kingoflolz/linear-actuator-hardware/readme.md

# Linear Actuator Hardware

A fully integrated PCB linear actuator, with the motor driver, encoder and motor all on a single PCB. All designs are
open source:

- [Firmware and host software](https://github.com/kingoflolz/linear-actuator-firmware)
- [Blog post with commentary](https://benwang.dev/2022/08/09/PCB-Linear-Actuator.html)

Files in this repository are licensed under the Apache-2.0 license
