kingoflolz/linear-actuator-hardware/mechanical/readme.md

# Mechanical components

| File | Material | Thickness  |
|---|---|---|
| Mount.stl | PLA | N/A |
| Stator plate 1.dxf | Mild steel | 3mm/0.119" |
| Stator plate 3.dxf | Mild steel | 3mm/0.119" |
| Stator spacer.dxf  | 5052 | 6.4mm/.25" |

The metal plates can be ordered at SendCutSend [here](https://cart.sendcutsend.com/1mcvzdwj3xs7)
