kingoflolz/linear-actuator-hardware/encoder_pcb/README.md

# Gerber generator for encoder PCB

What is GLIF?
========================
GLIF is a Gerber writer written in python. It takes graphical primitives such as lines, arcs, circles, polygons, and ASCII text and writes out valid RS-274X "Gerber" files. These files are typically used to manufacture PCBs.
