kingoflolz/linear-actuator-hardware/simulator/readme.md

# Magnetics Simulator

A python interface for [FEMM](https://www.femm.info/wiki/HomePage) which is used to implement a simulation for the linear actuator.
