kingoflolz/linear-actuator-hardware/simulator/idtestn0.bmp

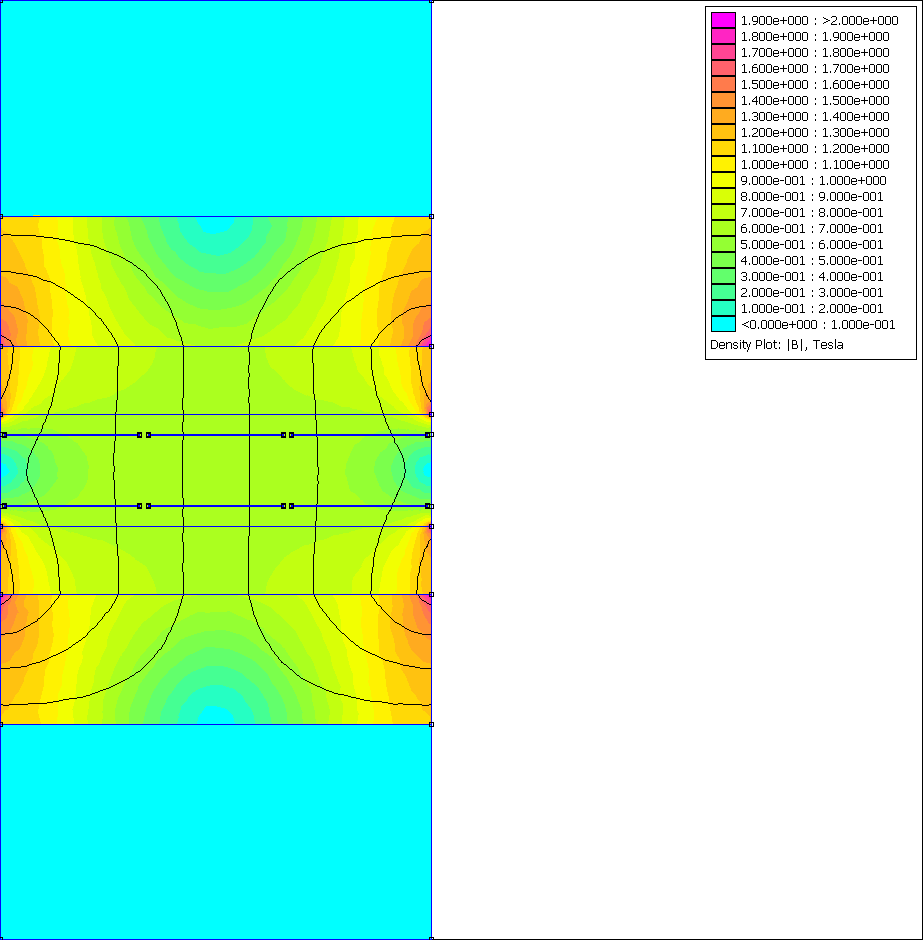
simulator/idtestn0.bmp
