kingoflolz/linear-actuator-hardware/mechanical/Part Studio 1 - Stator spacer.dxf

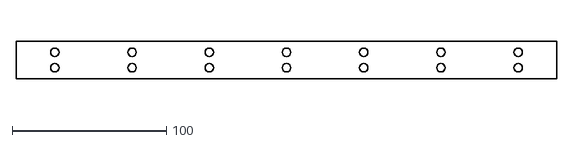
[picture p2: CAD file, 2022-08-09]
mechanical/Part Studio 1 - Stator spacer.dxf
350.0 x 24.0
