kingoflolz/linear-actuator-hardware/mechanical/Part Studio 1 - Stator plate 1.dxf

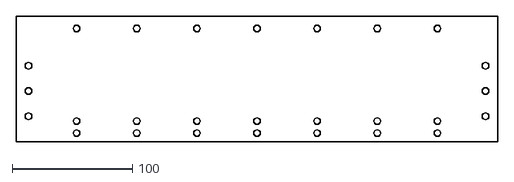
[picture p3: CAD file, 2022-08-09]
mechanical/Part Studio 1 - Stator plate 1.dxf
400.0 x 104.0
