kingoflolz/linear-actuator-hardware/mechanical/Part Studio 1 - Mount.stl

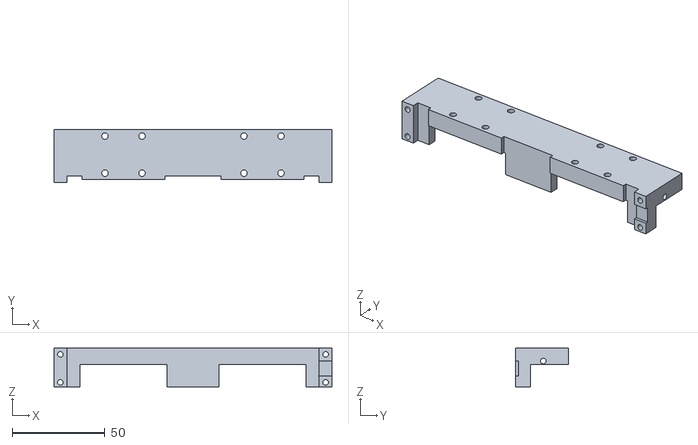
[picture p4: CAD file, 2022-08-09]
mechanical/Part Studio 1 - Mount.stl
150.0 x 28.5 x 21.0
