kingoflolz/linear-actuator-hardware/mechanical/Part Studio 1 - Stator plate 3.dxf

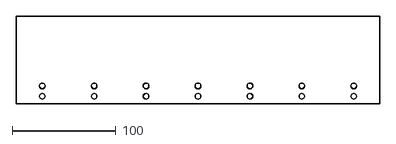
[picture p5: CAD file, 2022-08-09]
mechanical/Part Studio 1 - Stator plate 3.dxf
350.0 x 84.0
