kingoflolz/linear-actuator-hardware/motor_pcb/linear actuator 3/linear actuator.kicad_pcb

## KiCad design motor_pcb/linear actuator 3/linear actuator.kicad_pcb (2022-08-25)

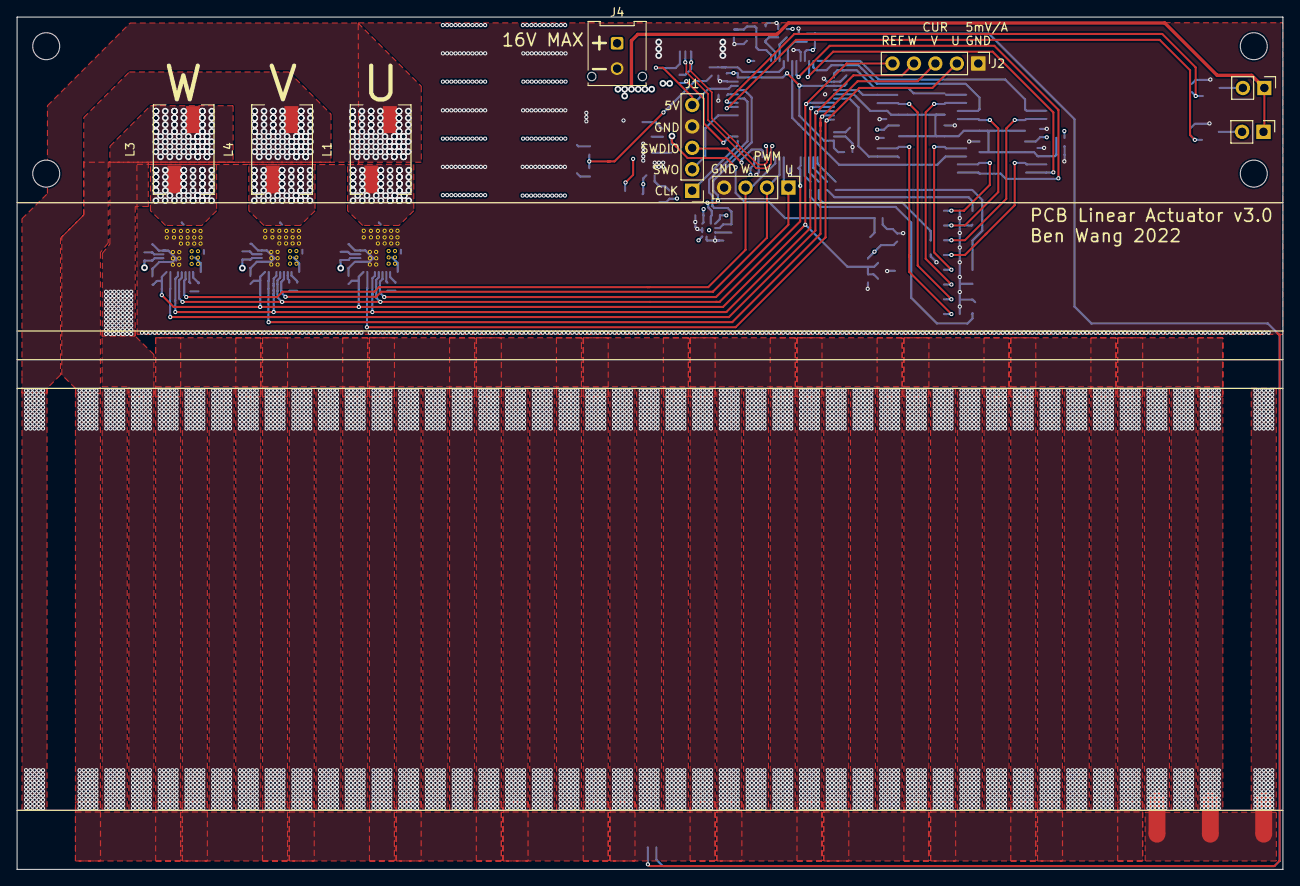
[picture p6: board motor_pcb/linear actuator 3/linear actuator.kicad_pcb from above]

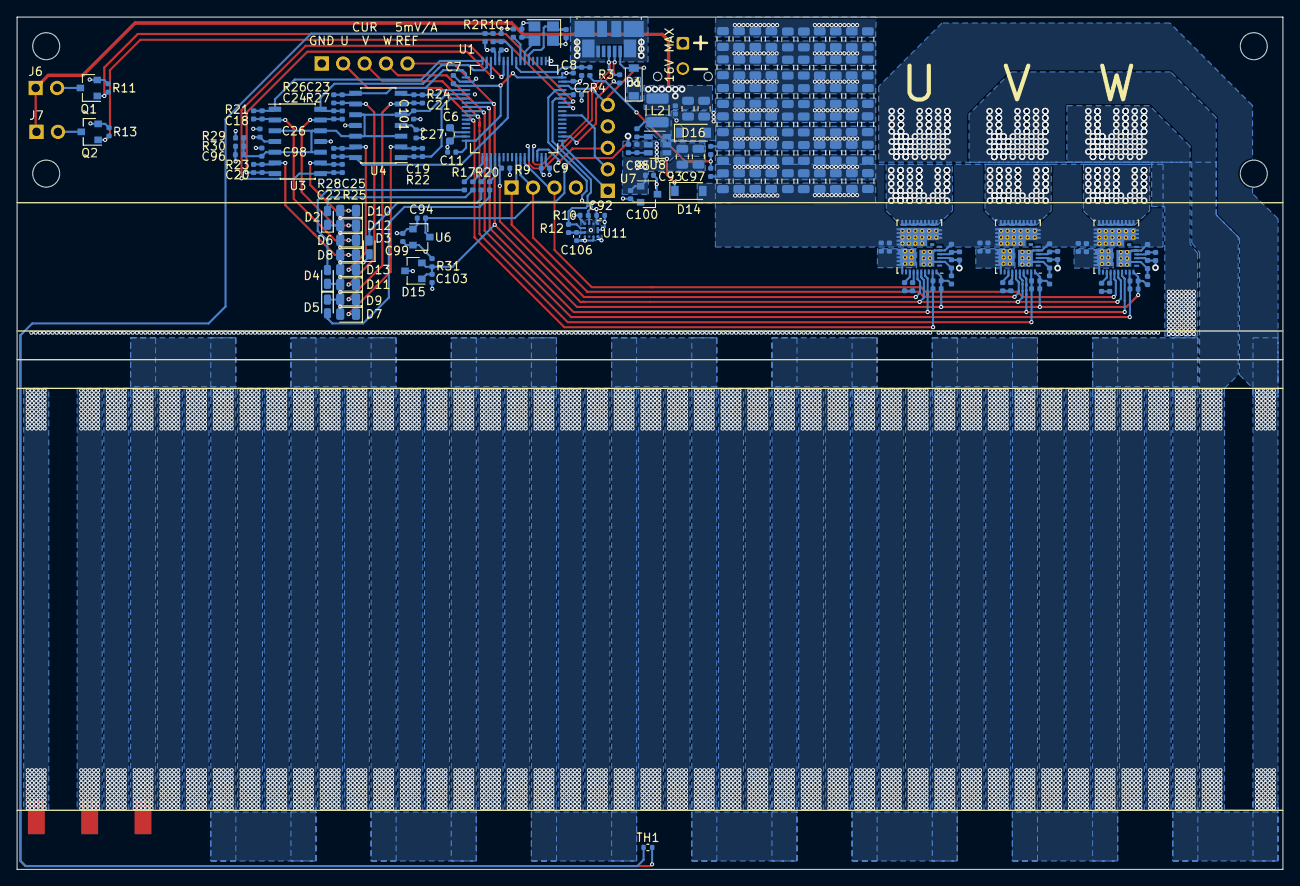
[picture p7: board motor_pcb/linear actuator 3/linear actuator.kicad_pcb from below]

Board: 4 copper layers, 150.0 x 101.0 mm, 204 parts (188 on the bottom side), 84 nets.

Parts:
C1, C7, C8, C9, C11, C12, C13, C14, C17, C26, C27, C94, C95, C96, C98, C99, C100, C101, C103, C107, C108, C109, C112, C115, C116, C117, C120: 1uF; C_0402_1005Metric
C2, C102: 10nF; C_0402_1005Metric
C3, C4: 12pF; C_0402_1005Metric
C5: 1uF; R_0402_1005Metric
C6: 4.7uF; C_0603_1608Metric
C10, C105, C113: 22pF; C_0402_1005Metric
C15, C110, C118: 220nF; C_0402_1005Metric
C16, C92, C104, C106, C111, C119: 0.1uF; C_0402_1005Metric
C18, C19, C20, C21, C22, C23, C24, C25: 6pF; C_0402_1005Metric
C28, C29, C30, C31, C32, C33, C34, C35, C37, C38, C39, C40, C41, C43, C44, C45, C46, C47, C48, C49, C50, C51, C52, C53, C54, C55, C56, C57, C58, C59, C60, C61, C62, C63, C64, C65, C66, C67, C68, C69, C70, C71, C72, C73, C74, C75, C76, C77, C78, C79, C80, C81, C82, C83, C84, C85, C86, C87, C88, C89, C93, C97: 4.7uF; C_0805_2012Metric
C36, C42: 22uF; C_0805_2012Metric
D1, D14, D16: D; D_SOD-123
D2, D3, D4, D5: LED; D_0603_1608Metric_Castellated
D6, D7, D8, D9, D10, D11, D12, D13: D_Photo; D_0805_2012Metric
D15: TL432DBZ; SOT-23
J1, J2: Conn_01x05_Male; PinHeader_1x05_P2.54mm_Vertical
J3: USB_B_Micro; USB_Micro-B_Molex_47346-0001
J4: Conn_01x02_Male; Molex_Micro-Fit_3.0_43045-0212_2x01_P3.00mm_Vertical
J5: Conn_01x04_Male; PinHeader_1x04_P2.54mm_Vertical
J6, J7: Conn_01x02_Male; PinHeader_1x02_P2.54mm_Vertical
L1, L3, L4: L; L_10x7_H10
L2: 10uH; L_1210_3225Metric
MH1, MH2, MH3, MH4: MountingHole; MountingHole_3.2mm_M3
NT1, NT2, NT3: Net-Tie_2; NetTie-2_SMD_Pad2.0mm
Q1, Q2: Q_NMOS_GSD; SOT-23
R1, R2, R5, R9: 10K; R_0402_1005Metric
R3: 1K5; R_0402_1005Metric
R4, R6, R7, R8, R11, R13, R14, R30, R35, R39: 1K; R_0402_1005Metric
R10, R12: 2.2K; R_0402_1005Metric
R15, R16, R36, R37, R40, R41: 2R; R_0402_1005Metric
R17, R18, R19, R20: 300R; R_0402_1005Metric
R21, R22, R23, R24, R25, R26, R27, R28: 220K; R_0402_1005Metric
R29: 4K7; R_0402_1005Metric
R31: 220R; R_0402_1005Metric
R32: 68K; R_0402_1005Metric
R33: 13K; R_0402_1005Metric
TH1: 10K; R_0402_1005Metric
U1: STM32F412RETx; LQFP-64_10x10mm_P0.5mm
U2, U9, U10: FDMF3170; QFN-40_5x6_Pitch0.45mm
U3, U4: OPA4340UA; SOIC-14_3.9x8.7mm_P1.27mm
U6, U7: APE8865N-33-HF-3; SOT-23
U8: LMR16006YQ; SOT-23-6
U11: KXTJ3-1057; Kionix_LGA-12_2x2mm_P0.5mm_LayoutBorder2x4y
Y1: Crystal_GND24; Crystal_SMD_3225-4Pin_3.2x2.5mm

Connections:
+1V2: C10.2, C12.1, C103.1, C105.2, C107.1, C113.2, C115.1, D15.1 (REF), D15.2 (K), J2.5, R14.2, R31.2, R35.2, R39.2, U1.23 (PA7), U2.39 (REFIN), U9.39 (REFIN), U10.39 (REFIN)
+3.3V: C7.1, C8.1, C9.1, C11.1, C92.1, C100.2, C106.1, R7.2, R10.1, R12.1, U1.1 (VBAT), U1.19 (VDD), U1.32 (VDD), U1.48 (VDD), U1.64 (VDD), U7.2 (VO), U11.1 (ADDR), U11.3 (IO_VDD), U11.7 (VDD), U11.10 (VDD), U11.11 (IO_VDD)
+3.3VA: C5.1, C26.1, C27.1, C99.2, R2.1, R29.1, R31.1, U1.13 (VDDA), U3.4 (V+), U4.4 (V+), U6.2 (VO)
+5V: C14.1, C36.1, C42.1, C94.1, C95.1, C104.1, C109.1, C117.1, D1.1 (K), J6.1, J7.1, L2.1, R15.1, R32.1, R36.1, R40.1, U2.3 (VCC), U6.3 (VI), U7.3 (VI), U9.3 (VCC), U10.3 (VCC)
/D_TEMP: U1.24 (PC4), U2.36 (TMON), U9.36 (TMON), U10.36 (TMON)
/FAN1: Q1.1 (G), R11.1, U1.58 (PB6)
/FAN2: Q2.1 (G), R13.1, U1.57 (PB5)
/I_U: C10.1, J2.2, R14.1, U1.27 (PB1), U2.38 (IMON)
/I_V: C113.1, J2.3, R39.1, U1.26 (PB0), U10.38 (IMON)
/I_W: C105.1, J2.4, R35.1, U1.25 (PC5), U9.38 (IMON)
/L1: R17.1, U1.34 (PB13)
/L2: R18.1, U1.33 (PB12)
/L3: R19.1, U1.35 (PB14)
/L4: R20.1, U1.36 (PB15)
/M_TEMP: C1.1, R1.2, U1.9 (PC1)
/O1: C19.1, R22.1, U1.22 (PA6), U4.1
/O2: C21.1, R24.1, U1.20 (PA4), U4.7
/O3: C23.1, R26.1, U1.17 (PA3), U4.8
/O4: C25.1, R28.1, U1.10 (PC2), U4.14
/O5: C18.1, R21.1, U1.16 (PA2), U3.1
/O6: C20.1, R23.1, U1.14 (PA0), U3.7
/O7: C22.1, R25.1, U1.11 (PC3), U3.8
/O8: C24.1, R27.1, U1.15 (PA1), U3.14
/PWM_EN: R9.2, U1.37 (PC6), U2.35 (EN), U9.35 (EN), U10.35 (EN)
/PWM_U: J5.1, U1.41 (PA8), U2.34 (PWM)
/PWM_V: J5.2, U1.42 (PA9), U10.34 (PWM)
/PWM_W: J5.3, U1.43 (PA10), U9.34 (PWM)
/SCL: R10.2, U1.61 (PB8), U11.12 (SCL)
/SDA: R12.2, U1.59 (PB7), U11.2 (SDA)
/STAR: NT1.2, NT2.2, NT3.2
/SWCLK: J1.1, U1.49 (PA14)
/SWDIO: J1.3, U1.46 (PA13)
/SWO: J1.2, U1.55 (PB3)
/U/MOTOR: L1.2, NT3.1
/USB_N: J3.2 (D-), U1.44 (PA11)
/USB_P: J3.3 (D+), R3.2, U1.45 (PA12)
/USB_PULL: R3.1, U1.50 (PA15)
/USB_S: D1.2 (A), J1.5, J3.1 (VBUS), U1.62 (PB9)
/V/MOTOR: L4.2, NT1.1
/VBUS_S: C2.1, R4.2, U1.8 (PC0)
/W/MOTOR: L3.2, NT2.1
/power/VBUS_D: C93.2, C97.2, D14.1 (K), U8.4 (~SHDN), U8.5 (VIN)
GND: C1.2, C2.2, C3.2, C4.2, C5.2, C6.2, C7.2, C8.2, C9.2, C11.2, C12.2, C13.2, C14.2, C16.1, C17.1, C26.2, C27.2, C28.1, C29.1, C30.1, C31.1, C32.1, C33.1, C34.1, C35.1, C36.2, C37.1, C38.1, C39.1, C40.1, C41.1, C42.2, C43.1, C44.1, C45.1, C46.1, C47.1, C48.1, C49.1, C50.1, C51.1, C52.1, C53.1, C54.1, C55.1, C56.1, C57.1, C58.1, C59.1, C60.1, C61.1, C62.1, C63.1, C64.1, C65.1, C66.1, C67.1, C68.1, C69.1, C70.1, C71.1, C72.1, C73.1, C74.1, C75.1, C76.1, C77.1, C78.1, C79.1, C80.1, C81.1, C82.1, C83.1, C84.1, C85.1, C86.1, C87.1, C88.1, C89.1, C92.2, C93.1, C94.2, C95.2, C96.1, C97.1, C98.1, C99.1, C100.1, C101.1, C103.2, C104.2, C106.2, C107.2, C108.2, C109.2, C111.1, C112.1, C115.2, C116.2, C117.2, C119.1, C120.1, D2.1 (K), D3.1 (K), D4.1 (K), D5.1 (K), D6.2 (A), D7.2 (A), D8.2 (A), D9.2 (A), D10.2 (A), D11.2 (A), D12.2 (A), D13.2 (A), D15.3 (A), D16.2 (A), J1.4, J2.1, J3.5 (GND), J3.6 (Shield), J4.2, J5.4, Q1.2 (S), Q2.2 (S), R6.2, R8.2, R9.1, R11.2, R13.2, R30.2, R33.2, TH1.2, U1.12 (VSSA), U1.18 (VSS), U1.31 (VSS), U1.47 (VSS), U1.63 (VSS), U2.2 (AGND), U2.5 (PGND), U2.7 (PGND), U2.40 (PGND), U3.11 (V-), U4.11 (V-), U6.1 (GND), U7.1 (GND), U8.2 (GND), U9.2 (AGND), U9.5 (PGND), U9.7 (PGND), U9.40 (PGND), U10.2 (AGND), U10.5 (PGND), U10.7 (PGND), U10.40 (PGND), U11.4 (RES), U11.6 (GND), U11.8 (GND), U11.9 (GND), Y1.2, Y1.4
unnamed: C3.1, U1.5 (PH0), Y1.1
unnamed: C4.1, U1.6 (PH1), Y1.3
unnamed: C6.1, U1.30 (VCAP_1)
unnamed: C13.1, R15.2, U2.4 (PVCC)
unnamed: C15.1, R16.1
unnamed: C15.2, U2.32 (PHASE)
unnamed: C18.2, D6.1 (K), R21.2, U3.2 (-)
unnamed: C19.2, D7.1 (K), R22.2, U4.2 (-)
unnamed: C20.2, D8.1 (K), R23.2, U3.6 (-)
unnamed: C21.2, D9.1 (K), R24.2, U4.6 (-)
unnamed: C22.2, D10.1 (K), R25.2, U3.9 (-)
unnamed: C23.2, D11.1 (K), R26.2, U4.9 (-)
unnamed: C24.2, D12.1 (K), R27.2, U3.13 (-)
unnamed: C25.2, D13.1 (K), R28.2, U4.13 (-)
unnamed: C102.1, U8.1 (CB)
unnamed: C102.2, D16.1 (K), L2.2, U8.6 (SW)
unnamed: C108.1, R36.2, U9.4 (PVCC)
unnamed: C110.1, R37.1
unnamed: C110.2, U9.32 (PHASE)
unnamed: C116.1, R40.2, U10.4 (PVCC)
unnamed: C118.1, R41.1
unnamed: C118.2, U10.32 (PHASE)
unnamed: D2.2 (A), R17.2
unnamed: D3.2 (A), R19.2
unnamed: D4.2 (A), R18.2
unnamed: D5.2 (A), R20.2
unnamed: J6.2, Q1.3 (D)
unnamed: J7.2, Q2.3 (D)
unnamed: L1.1, U2.10 (SW)
unnamed: L3.1, U9.10 (SW)
unnamed: L4.1, U10.10 (SW)
unnamed: R1.1, R2.2, TH1.1
unnamed: R4.1, R5.2, R6.1
unnamed: R7.1, U1.7 (NRST)
unnamed: R8.1, U1.60 (BOOT0)
unnamed: R16.2, U2.33 (BOOT)
unnamed: R32.2, R33.1, U8.3 (FB)
unnamed: R37.2, U9.33 (BOOT)
unnamed: R41.2, U10.33 (BOOT)
VBUS: C16.2, C17.2, C28.2, C29.2, C30.2, C31.2, C32.2, C33.2, C34.2, C35.2, C37.2, C38.2, C39.2, C40.2, C41.2, C43.2, C44.2, C45.2, C46.2, C47.2, C48.2, C49.2, C50.2, C51.2, C52.2, C53.2, C54.2, C55.2, C56.2, C57.2, C58.2, C59.2, C60.2, C61.2, C62.2, C63.2, C64.2, C65.2, C66.2, C67.2, C68.2, C69.2, C70.2, C71.2, C72.2, C73.2, C74.2, C75.2, C76.2, C77.2, C78.2, C79.2, C80.2, C81.2, C82.2, C83.2, C84.2, C85.2, C86.2, C87.2, C88.2, C89.2, C111.2, C112.2, C119.2, C120.2, D14.2 (A), J4.1, R5.1, U2.25 (VIN), U2.30 (VIN), U9.25 (VIN), U9.30 (VIN), U10.25 (VIN), U10.30 (VIN)
V_BIAS: C96.2, C98.2, C101.2, R29.2, R30.1, U1.21 (PA5), U3.3 (+), U3.5 (+), U3.10 (+), U3.12 (+), U4.3 (+), U4.5 (+), U4.10 (+), U4.12 (+)
