kingoflolz/linear-actuator-hardware/motor_pcb/linear actuator/linear actuator.kicad_pcb

## KiCad design motor_pcb/linear actuator/linear actuator.kicad_pcb (2022-08-09, an earlier design)

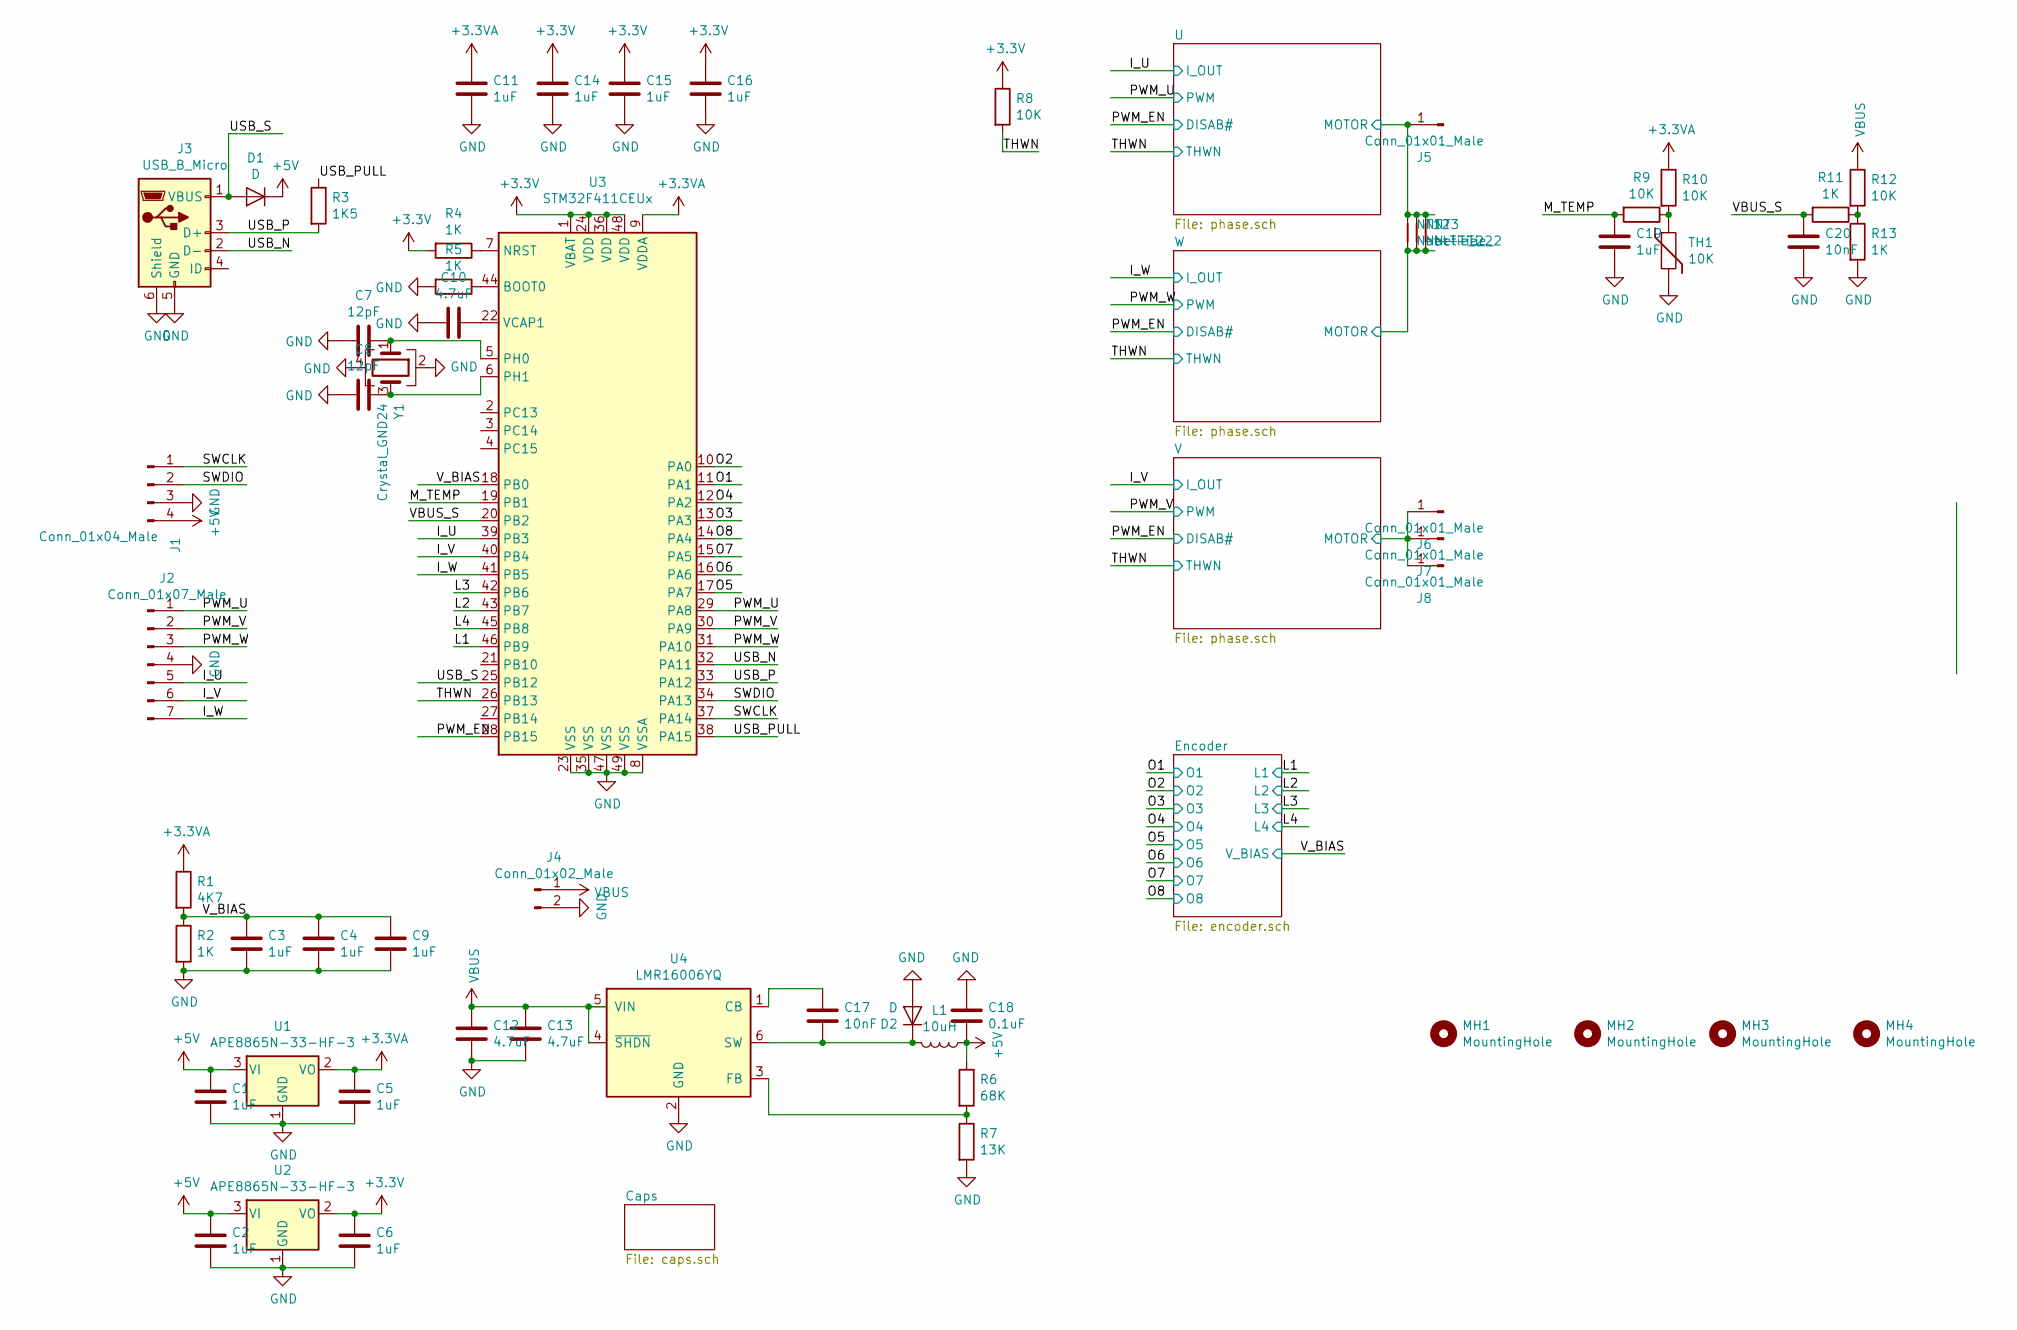
[picture p8: schematic linear actuator.sch]

Parts:
C1, C2, C3, C4, C5, C6, C9, C14, C15, C16, C19: 1uF; C_0402_1005Metric
C7, C8: 12pF; C_0402_1005Metric
C10: 4.7uF; C_0603_1608Metric
C11: 1uF; R_0402_1005Metric
C12, C13: 4.7uF; C_0805_2012Metric
C17, C20: 10nF; C_0402_1005Metric
C18: 0.1uF; C_0603_1608Metric
D1, D2: D; D_SOD-123
J1: Conn_01x04_Male; PinHeader_1x04_P2.54mm_Vertical
J2: Conn_01x07_Male; PinHeader_1x07_P2.54mm_Vertical
J3: USB_B_Micro; USB_Micro-B_Molex_47346-0001
J4: Conn_01x02_Male; PinHeader_1x02_P2.54mm_Vertical
J5, J6, J7, J8: Conn_01x01_Male; landing_pad
L1: 10uH; L_1210_3225Metric
MH1, MH2, MH3, MH4: MountingHole; MountingHole_3.2mm_M3
NT1, NT2, NT3: Net-Tie_2; NetTie-2_SMD_Pad2.0mm
R1: 4K7; R_0402_1005Metric
R2, R4, R5, R11, R13: 1K; R_0402_1005Metric
R3: 1K5; R_0402_1005Metric
R6: 68K; R_0402_1005Metric
R7: 13K; R_0402_1005Metric
R8, R9, R10, R12: 10K; R_0402_1005Metric
TH1: 10K; R_0402_1005Metric
U1, U2: APE8865N-33-HF-3; SOT-23
U3: STM32F411CEUx; QFN-48-1EP_7x7mm_P0.5mm_EP5.6x5.6mm
U4: LMR16006YQ; SOT-23-6
Y1: Crystal_GND24; Crystal_SMD_3225-4Pin_3.2x2.5mm

Connections:
+3.3VA: C5.2, C11.1, R1.1, R10.1, U1.2 (VO), U3.9 (VDDA); also elsewhere on the board
+3V3: C6.2, C14.1, C15.1, C16.1, R4.2, R8.1, U2.2 (VO), U3.1 (VBAT), U3.24 (VDD), U3.36 (VDD), U3.48 (VDD)
+5V: C1.1, C2.1, C18.1, D1.1 (K), J1.4, L1.1, R6.1, U1.3 (VI), U2.3 (VI); also elsewhere on the board
/I_U: J2.5, U3.39 (PB3); also elsewhere on the board
/I_V: J2.6, U3.40 (PB4); also elsewhere on the board
/I_W: J2.7, U3.41 (PB5); also elsewhere on the board
/L1: U3.46 (PB9); also elsewhere on the board
/L2: U3.43 (PB7); also elsewhere on the board
/L3: U3.42 (PB6); also elsewhere on the board
/L4: U3.45 (PB8); also elsewhere on the board
/M_TEMP: C19.1, R9.2, U3.19 (PB1)
/O1: U3.11 (PA1); also elsewhere on the board
/O2: U3.10 (PA0); also elsewhere on the board
/O3: U3.13 (PA3); also elsewhere on the board
/O4: U3.12 (PA2); also elsewhere on the board
/O5: U3.17 (PA7); also elsewhere on the board
/O6: U3.16 (PA6); also elsewhere on the board
/O7: U3.15 (PA5); also elsewhere on the board
/O8: U3.14 (PA4); also elsewhere on the board
/PWM_EN: U3.28 (PB15); also elsewhere on the board
/PWM_U: J2.1, U3.29 (PA8); also elsewhere on the board
/PWM_V: J2.2, U3.30 (PA9); also elsewhere on the board
/PWM_W: J2.3, U3.31 (PA10); also elsewhere on the board
/SWCLK: J1.1, U3.37 (PA14)
/SWDIO: J1.2, U3.34 (PA13)
/THWN: R8.2, U3.26 (PB13); also elsewhere on the board
/U/MOTOR: J5.1, NT1.1, NT2.1, NT3.1; also elsewhere on the board
/USB_N: J3.2 (D-), U3.32 (PA11)
/USB_P: J3.3 (D+), R3.2, U3.33 (PA12)
/USB_PULL: R3.1, U3.38 (PA15)
/USB_S: D1.2 (A), J3.1 (VBUS), U3.25 (PB12)
/V/MOTOR: J6.1, J7.1, J8.1; also elsewhere on the board
/VBUS_S: C20.1, R11.2, U3.20 (PB2)
/V_BIAS: C3.2, C4.2, C9.2, R1.2, R2.1, U3.18 (PB0); also elsewhere on the board
/W/MOTOR: NT1.2, NT2.2, NT3.2; also elsewhere on the board
GND: C1.2, C2.2, C3.1, C4.1, C5.1, C6.1, C7.2, C8.2, C9.1, C10.2, C11.2, C12.1, C13.1, C14.2, C15.2, C16.2, C18.2, C19.2, C20.2, D2.2 (A), J1.3, J2.4, J3.5 (GND), J3.6 (Shield), J4.2, R2.2, R5.2, R7.2, R13.2, TH1.2, U1.1 (GND), U2.1 (GND), U3.8 (VSSA), U3.23 (VSS), U3.35 (VSS), U3.47 (VSS), U3.49 (VSS), U4.2 (GND), Y1.2, Y1.4; also elsewhere on the board
unnamed: C7.1, U3.5 (PH0), Y1.1
unnamed: C8.1, U3.6 (PH1), Y1.3
unnamed: C10.1, U3.22 (VCAP1)
unnamed: C17.1, U4.1 (CB)
unnamed: C17.2, D2.1 (K), L1.2, U4.6 (SW)
unnamed: R4.1, U3.7 (NRST)
unnamed: R5.1, U3.44 (BOOT0)
unnamed: R6.2, R7.1, U4.3 (FB)
unnamed: R9.1, R10.2, TH1.1
unnamed: R11.1, R12.2, R13.1
VBUS: C12.2, C13.2, J4.1, R12.1, U4.4 (~SHDN), U4.5 (VIN); also elsewhere on the board

Schematic: phase.sch

Parts:
C21, C22, C24: 1uF; C_0402_1005Metric
C23: 0.1uF; C_0603_1608Metric
C25: 4.7uF; C_0805_2012Metric
C26: 100nF; C_0402_1005Metric
C27: 10nF; C_0402_1005Metric
L2: L; L_10.4x10.4_H4.8
R14: 10R; R_0402_1005Metric
R15: 2R; R_0402_1005Metric
R16: 10K; R_0402_1005Metric
U5: NCP302155; PQFN-31_5x5_Pitch0.5mm
U6: ACS712xLCTR-20A; SOIC-8_3.9x4.9mm_P1.27mm

Connections:
+3.3VA: C24.2, U6.8 (VCC); also elsewhere on the board
+5V: C21.1, R14.1, U5.29; also elsewhere on the board
/I_U: C27.1, R16.1; also elsewhere on the board
/PWM_EN: U5.31; also elsewhere on the board
/PWM_U: U5.1; also elsewhere on the board
/THWN: U5.30; also elsewhere on the board
/U/MOTOR: L2.2; also elsewhere on the board
GND: C21.2, C22.2, C23.1, C24.1, C25.1, C27.2, U5.4, U5.12, U5.28, U5.32, U6.5 (GND); also elsewhere on the board
unnamed: C22.1, R14.2, U5.3
unnamed: C26.1, R15.1
unnamed: C26.2, U5.7
unnamed: L2.1, U6.1 (IP+), U6.2 (IP+)
unnamed: R15.2, U5.5
unnamed: R16.2, U6.7 (VIOUT)
unnamed: U5.16, U6.3 (IP-), U6.4 (IP-)
unnamed: U5.27, U5.33
VBUS: C23.2, C25.2, U5.8; also elsewhere on the board

Parts of its further copies:
C28, C29, C31, C107, C108, C110: 1uF; C_0402_1005Metric
C30, C109: 0.1uF; C_0603_1608Metric
C32, C111: 4.7uF; C_0805_2012Metric
C33, C112: 100nF; C_0402_1005Metric
C34, C113: 10nF; C_0402_1005Metric
L3, L4: L; L_10.4x10.4_H4.8
R17, R32: 10R; R_0402_1005Metric
R18, R33: 2R; R_0402_1005Metric
R19, R34: 10K; R_0402_1005Metric
U7, U11: NCP302155; PQFN-31_5x5_Pitch0.5mm
U8, U12: ACS712xLCTR-20A; SOIC-8_3.9x4.9mm_P1.27mm

Connections of its further copies:
+3.3VA: C31.2, C110.2, U8.8 (VCC), U12.8 (VCC); also elsewhere on the board
+5V: C28.1, C107.1, R17.1, R32.1, U7.29, U11.29; also elsewhere on the board
/I_V: C34.1, R19.1; also elsewhere on the board
/I_W: C113.1, R34.1; also elsewhere on the board
/PWM_EN: U7.31, U11.31; also elsewhere on the board
/PWM_V: U7.1; also elsewhere on the board
/PWM_W: U11.1; also elsewhere on the board
/THWN: U7.30, U11.30; also elsewhere on the board
/V/MOTOR: L3.2; also elsewhere on the board
/W/MOTOR: L4.2; also elsewhere on the board
GND: C28.2, C29.2, C30.1, C31.1, C32.1, C34.2, C107.2, C108.2, C109.1, C110.1, C111.1, C113.2, U7.4, U7.12, U7.28, U7.32, U8.5 (GND), U11.4, U11.12, U11.28, U11.32, U12.5 (GND); also elsewhere on the board
unnamed: C29.1, R17.2, U7.3
unnamed: C33.1, R18.1
unnamed: C33.2, U7.7
unnamed: C108.1, R32.2, U11.3
unnamed: C112.1, R33.1
unnamed: C112.2, U11.7
unnamed: L3.1, U8.1 (IP+), U8.2 (IP+)
unnamed: L4.1, U12.1 (IP+), U12.2 (IP+)
unnamed: R18.2, U7.5
unnamed: R19.2, U8.7 (VIOUT)
unnamed: R33.2, U11.5
unnamed: R34.2, U12.7 (VIOUT)
unnamed: U7.16, U8.3 (IP-), U8.4 (IP-)
unnamed: U7.27, U7.33
unnamed: U11.16, U12.3 (IP-), U12.4 (IP-)
unnamed: U11.27, U11.33
VBUS: C30.2, C32.2, C109.2, C111.2, U7.8, U11.8; also elsewhere on the board

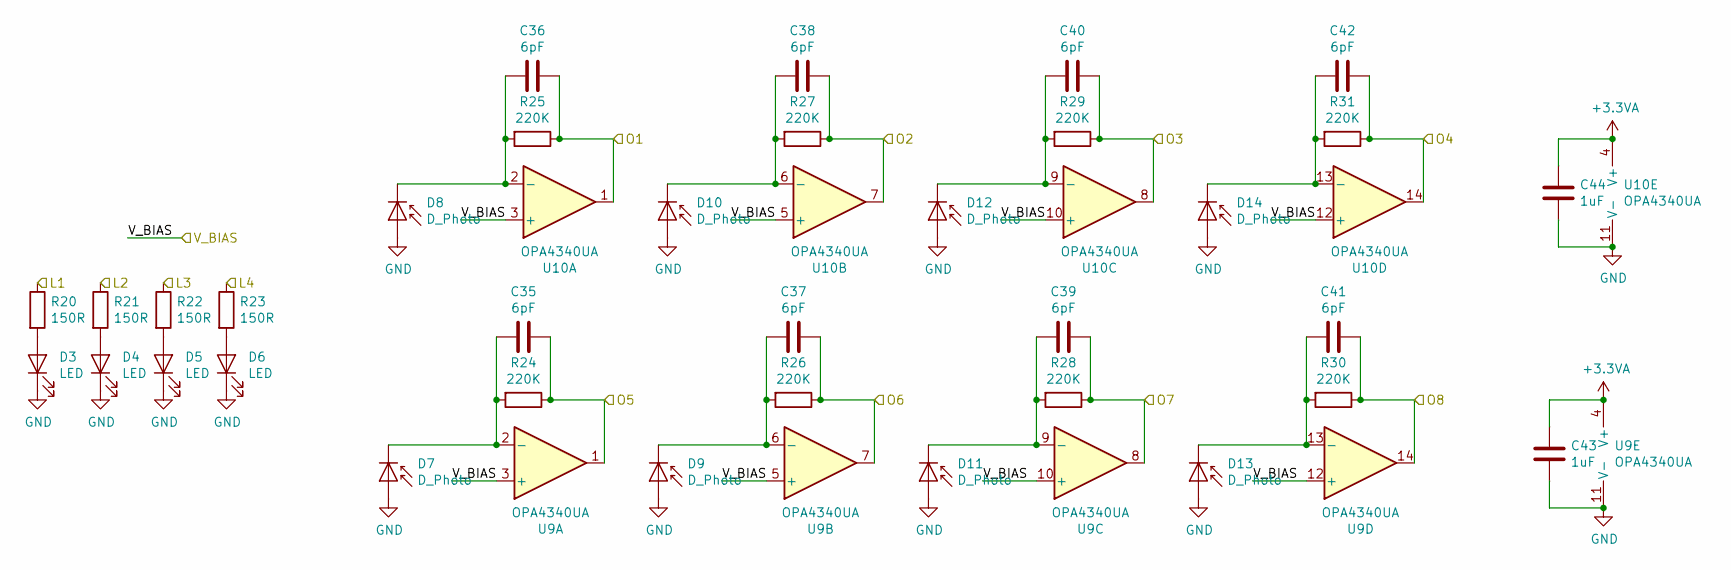
[picture p9: schematic encoder.sch]

Parts:
C35, C36, C37, C38, C39, C40, C41, C42: 6pF; C_0402_1005Metric
C43, C44: 1uF; C_0402_1005Metric
D3, D4, D5, D6: LED; D_0603_1608Metric_Castellated
D7, D8, D9, D10, D11, D12, D13, D14: D_Photo; D_0805_2012Metric
R20, R21, R22, R23: 150R; R_0402_1005Metric
R24, R25, R26, R27, R28, R29, R30, R31: 220K; R_0402_1005Metric
U9, U10: OPA4340UA; SOIC-14_3.9x8.7mm_P1.27mm

Connections:
+3.3VA: C43.1, C44.1, U9.4 (V+), U10.4 (V+); also elsewhere on the board
/L1: R20.1; also elsewhere on the board
/L2: R21.1; also elsewhere on the board
/L3: R22.1; also elsewhere on the board
/L4: R23.1; also elsewhere on the board
/O1: C36.1, R25.1, U10.1; also elsewhere on the board
/O2: C38.1, R27.1, U10.7; also elsewhere on the board
/O3: C40.1, R29.1, U10.8; also elsewhere on the board
/O4: C42.1, R31.1, U10.14; also elsewhere on the board
/O5: C35.1, R24.1, U9.1; also elsewhere on the board
/O6: C37.1, R26.1, U9.7; also elsewhere on the board
/O7: C39.1, R28.1, U9.8; also elsewhere on the board
/O8: C41.1, R30.1, U9.14; also elsewhere on the board
/V_BIAS: U9.3 (+), U9.5 (+), U9.10 (+), U9.12 (+), U10.3 (+), U10.5 (+), U10.10 (+), U10.12 (+); also elsewhere on the board
GND: C43.2, C44.2, D3.1 (K), D4.1 (K), D5.1 (K), D6.1 (K), D7.2 (A), D8.2 (A), D9.2 (A), D10.2 (A), D11.2 (A), D12.2 (A), D13.2 (A), D14.2 (A), U9.11 (V-), U10.11 (V-); also elsewhere on the board
unnamed: C35.2, D7.1 (K), R24.2, U9.2 (-)
unnamed: C36.2, D8.1 (K), R25.2, U10.2 (-)
unnamed: C37.2, D9.1 (K), R26.2, U9.6 (-)
unnamed: C38.2, D10.1 (K), R27.2, U10.6 (-)
unnamed: C39.2, D11.1 (K), R28.2, U9.9 (-)
unnamed: C40.2, D12.1 (K), R29.2, U10.9 (-)
unnamed: C41.2, D13.1 (K), R30.2, U9.13 (-)
unnamed: C42.2, D14.1 (K), R31.2, U10.13 (-)
unnamed: D3.2 (A), R20.2
unnamed: D4.2 (A), R21.2
unnamed: D5.2 (A), R22.2
unnamed: D6.2 (A), R23.2

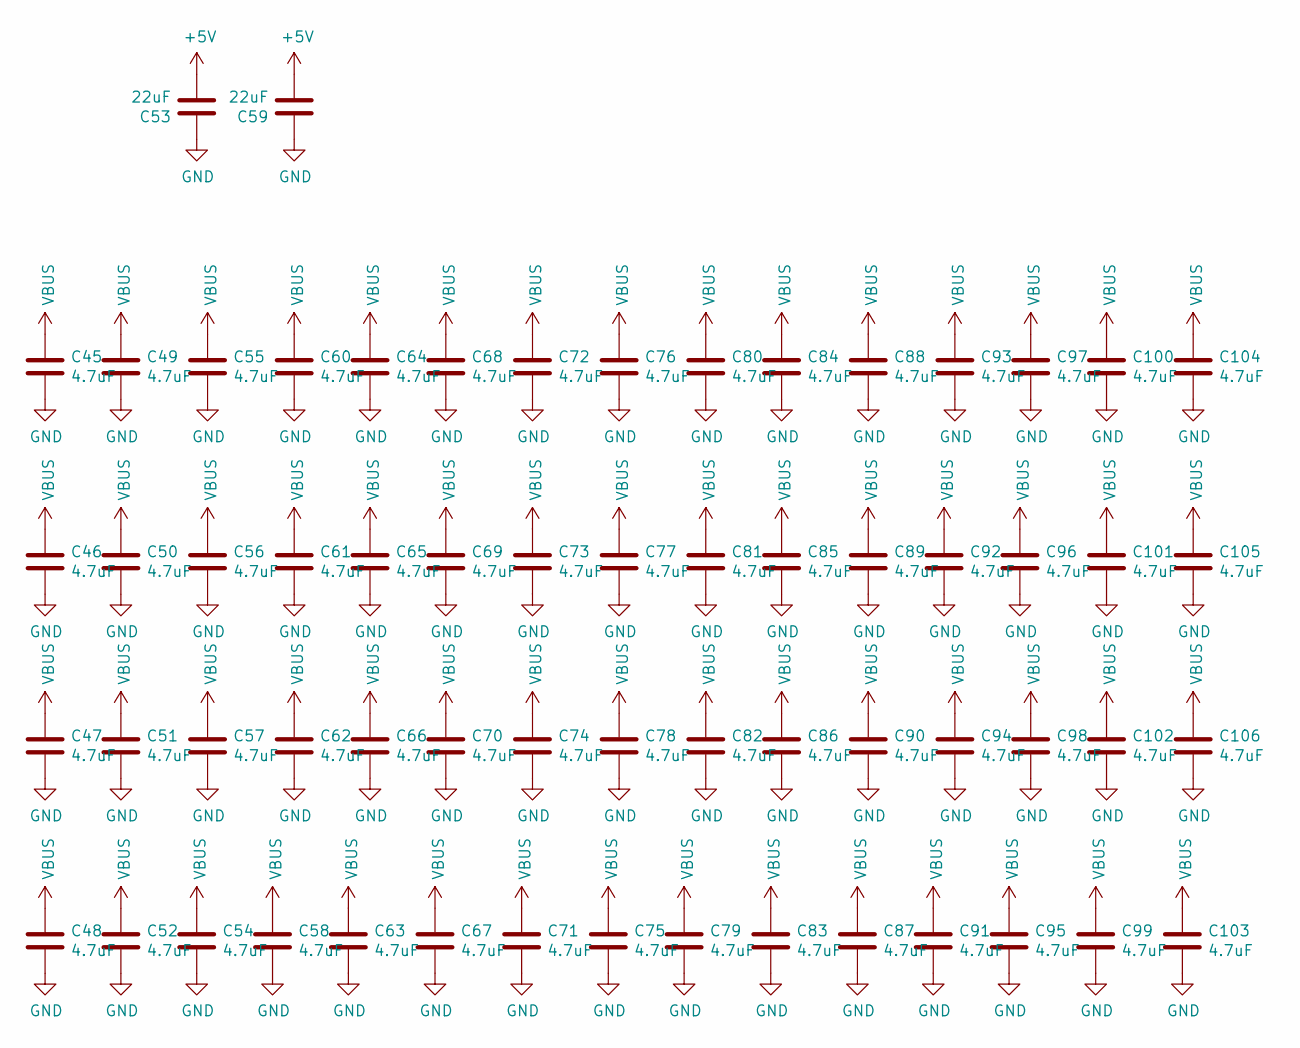
[picture p10: schematic caps.sch]

Parts:
C45, C46, C47, C48, C49, C50, C51, C52, C54, C55, C56, C57, C58, C60, C61, C62, C63, C64, C65, C66, C67, C68, C69, C70, C71, C72, C73, C74, C75, C76, C77, C78, C79, C80, C81, C82, C83, C84, C85, C86, C87, C88, C89, C90, C91, C92, C93, C94, C95, C96, C97, C98, C99, C100, C101, C102, C103, C104, C105, C106: 4.7uF; C_0805_2012Metric
C53, C59: 22uF; C_0805_2012Metric

Connections:
+5V: C53.1, C59.1; also elsewhere on the board
GND: C45.1, C46.1, C47.1, C48.1, C49.1, C50.1, C51.1, C52.1, C53.2, C54.1, C55.1, C56.1, C57.1, C58.1, C59.2, C60.1, C61.1, C62.1, C63.1, C64.1, C65.1, C66.1, C67.1, C68.1, C69.1, C70.1, C71.1, C72.1, C73.1, C74.1, C75.1, C76.1, C77.1, C78.1, C79.1, C80.1, C81.1, C82.1, C83.1, C84.1, C85.1, C86.1, C87.1, C88.1, C89.1, C90.1, C91.1, C92.1, C93.1, C94.1, C95.1, C96.1, C97.1, C98.1, C99.1, C100.1, C101.1, C102.1, C103.1, C104.1, C105.1, C106.1; also elsewhere on the board
VBUS: C45.2, C46.2, C47.2, C48.2, C49.2, C50.2, C51.2, C52.2, C54.2, C55.2, C56.2, C57.2, C58.2, C60.2, C61.2, C62.2, C63.2, C64.2, C65.2, C66.2, C67.2, C68.2, C69.2, C70.2, C71.2, C72.2, C73.2, C74.2, C75.2, C76.2, C77.2, C78.2, C79.2, C80.2, C81.2, C82.2, C83.2, C84.2, C85.2, C86.2, C87.2, C88.2, C89.2, C90.2, C91.2, C92.2, C93.2, C94.2, C95.2, C96.2, C97.2, C98.2, C99.2, C100.2, C101.2, C102.2, C103.2, C104.2, C105.2, C106.2; also elsewhere on the board

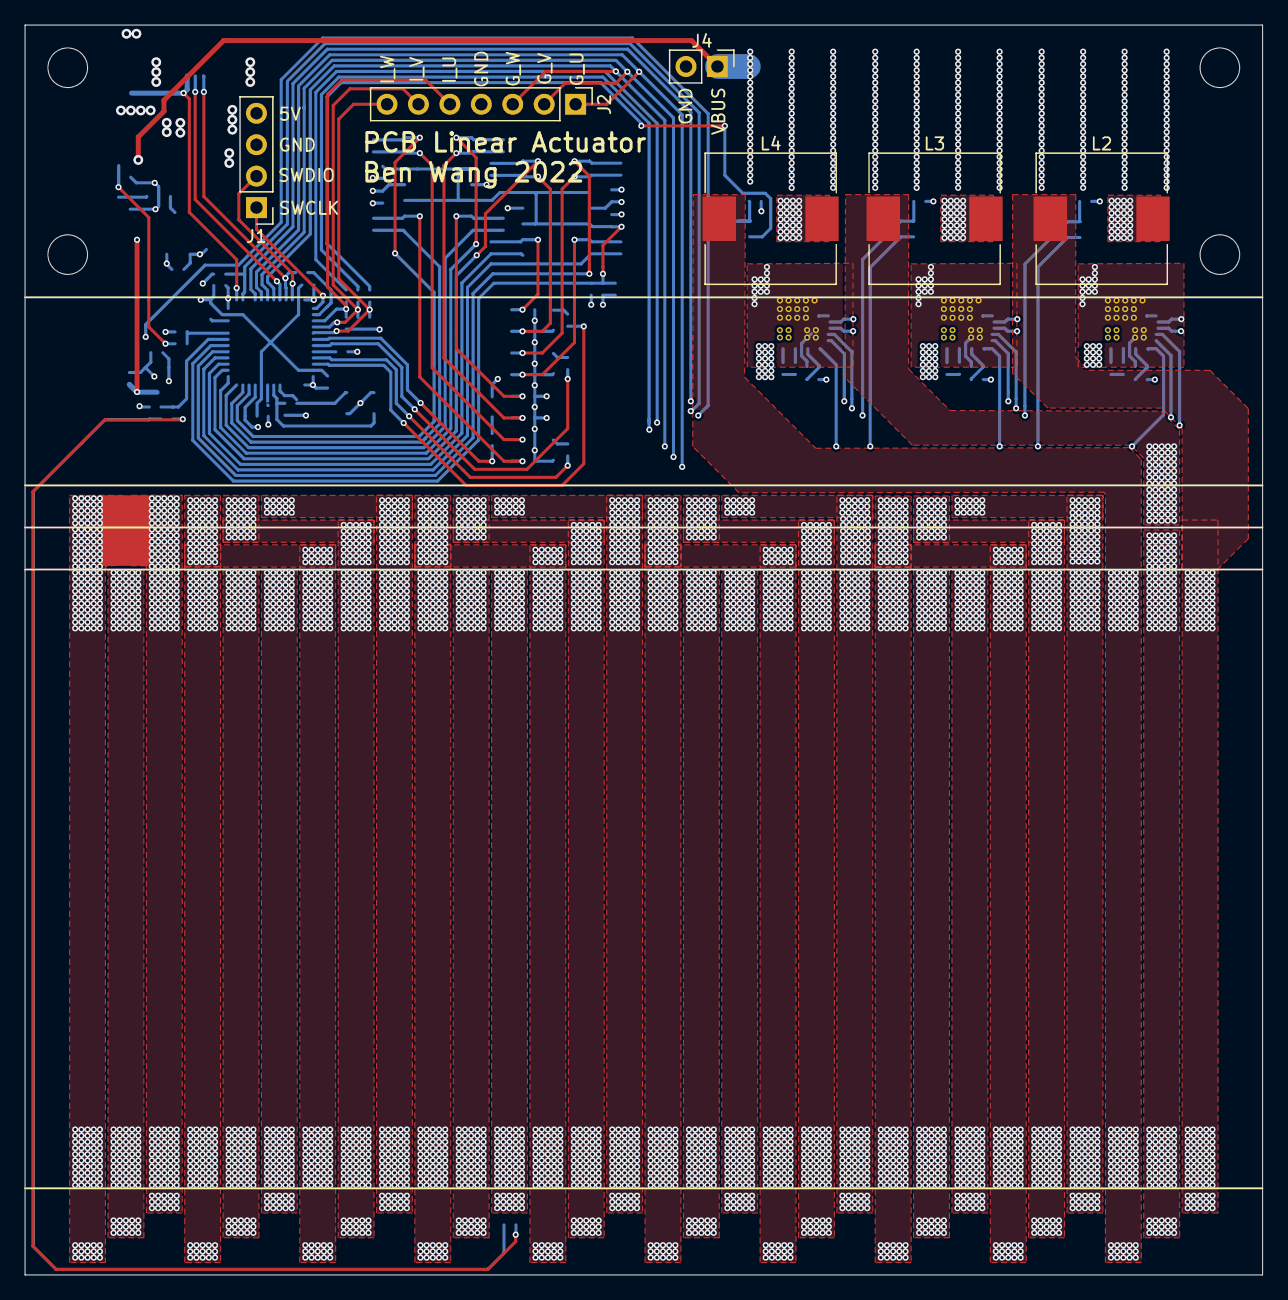
[picture p11: board motor_pcb/linear actuator/linear actuator.kicad_pcb from above]

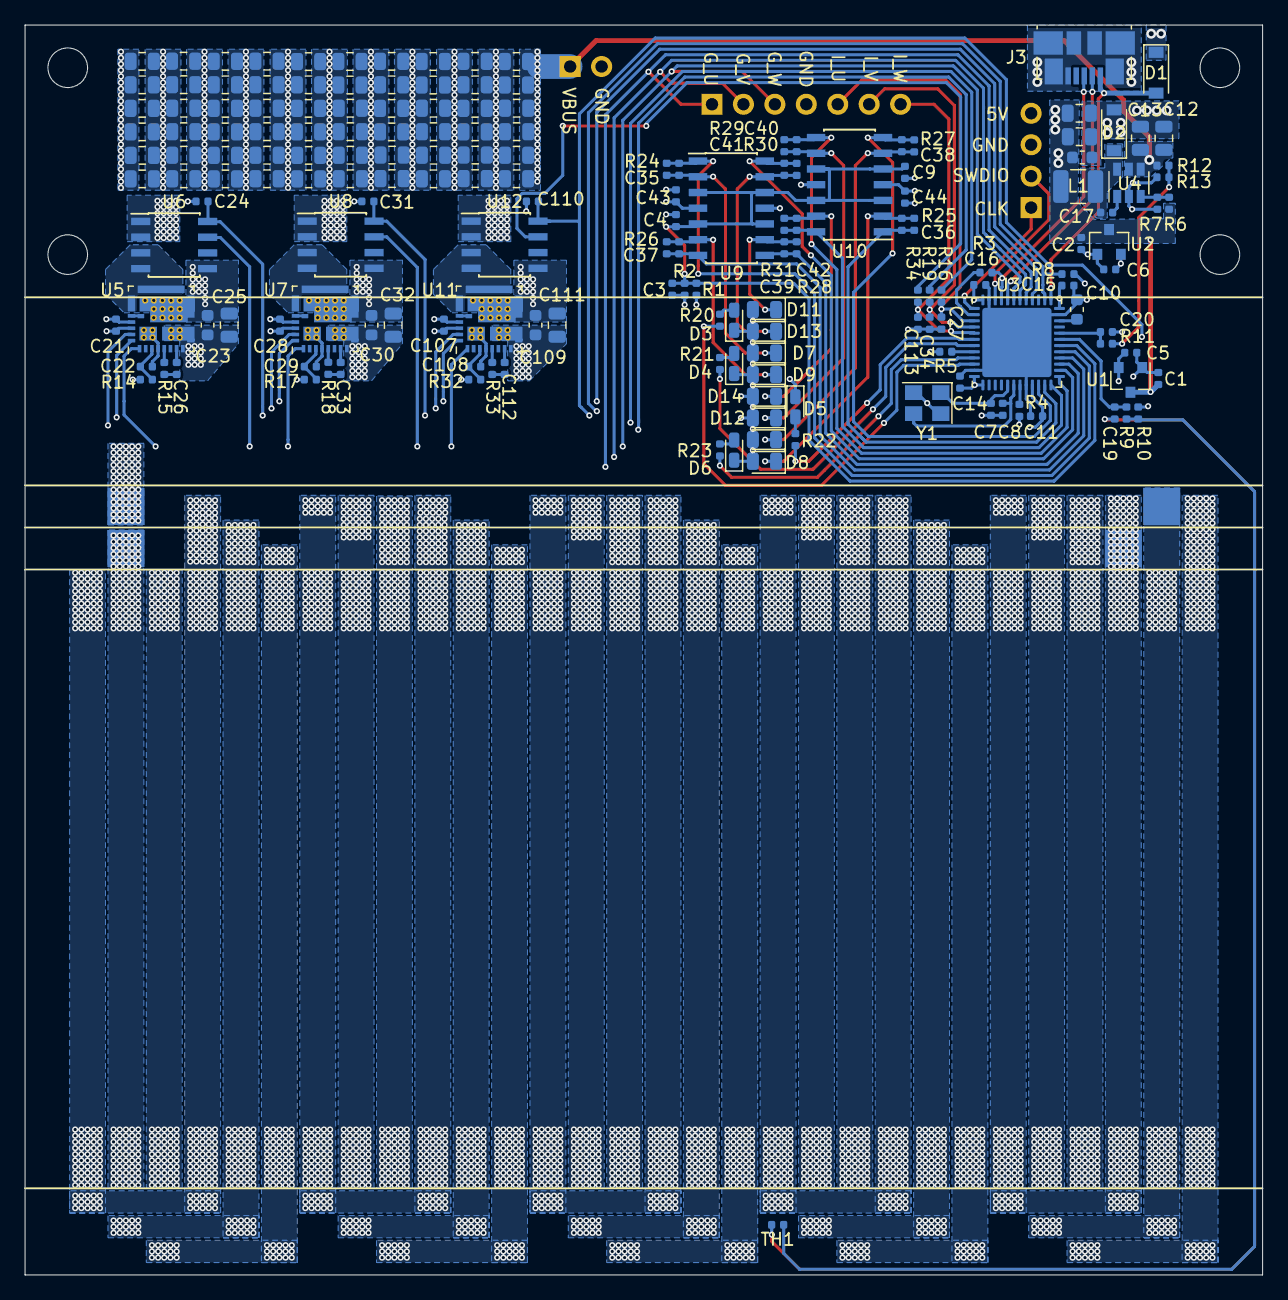
[picture p12: board motor_pcb/linear actuator/linear actuator.kicad_pcb from below]

Board: 4 copper layers, 100.0 x 101.0 mm, 194 parts (181 on the bottom side), 83 nets.
